brycecherry75/SeriesLoadLimiter/Programmable AC Series Limiter.pdf

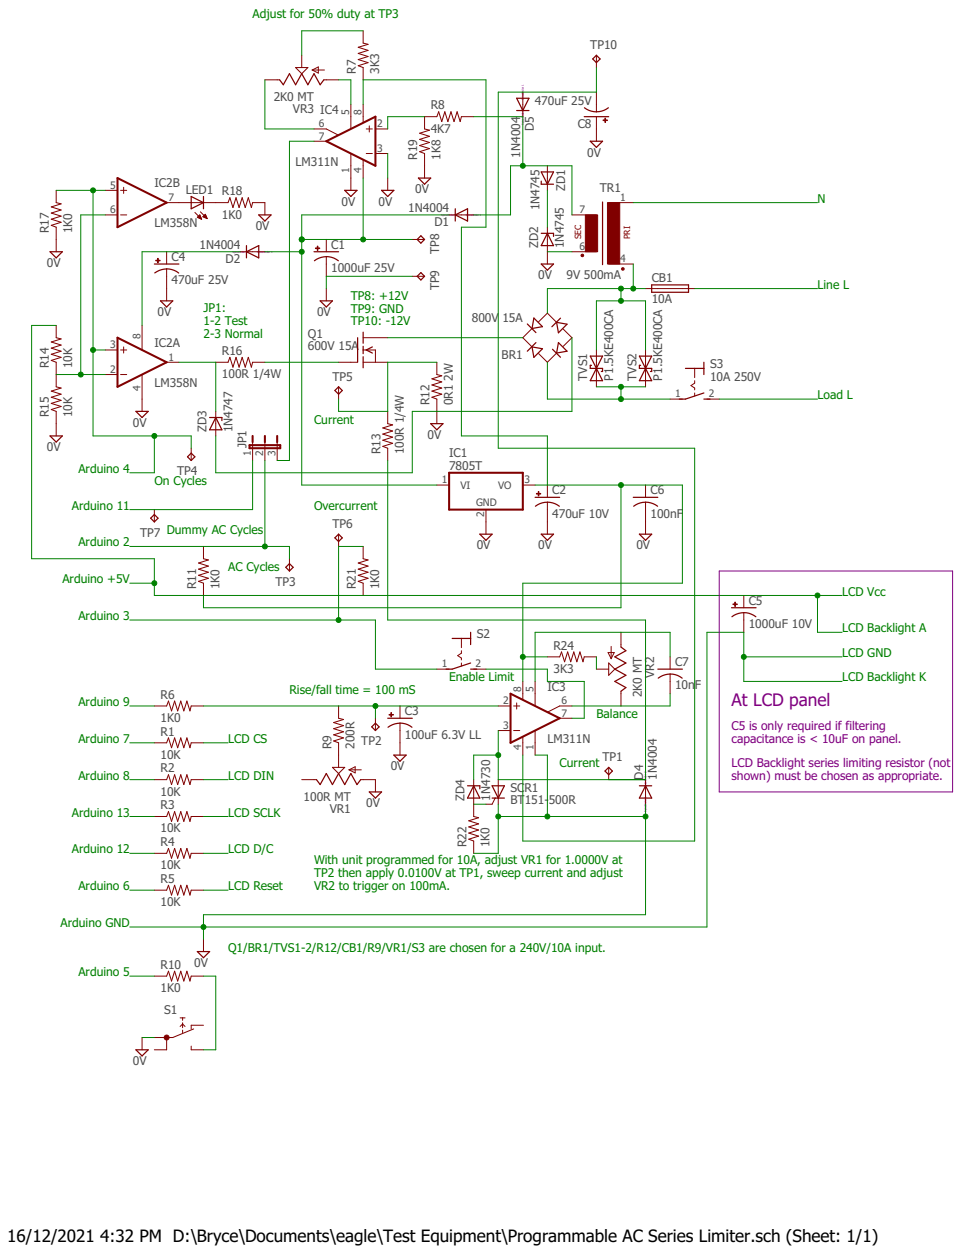
[picture p1: page 1]

Adjust for 50% duty at TP3

LCD Vcc LCD Backlight A

Rise/fall time = 100 mS

LCD Backlight series limiting resistor (not shown) must be chosen as appropriate. At LCD panel

C5 is only required if filtering
capacitance is < 10uF on panel.

With unit programmed for 10A, adjust VR1 for 1.0000V at
TP2 then apply 0.0100V at TP1, sweep current and adjust
VR2 to trigger on 100mA.

Q1/BR1/TVS1-2/R12/CB1/R9/VR1/S3 are chosen for a 240V/10A input. Arduino GND

16/12/2021 4:32 PM D:\Bryce\Documents\eagle\Test Equipment\Programmable AC Series Limiter.sch (Sheet: 1/1)
