brycecherry75/SeriesLoadLimiter/Programmable AC Series Limiter.sch

## EAGLE design Programmable AC Series Limiter.sch (2021-07-10)

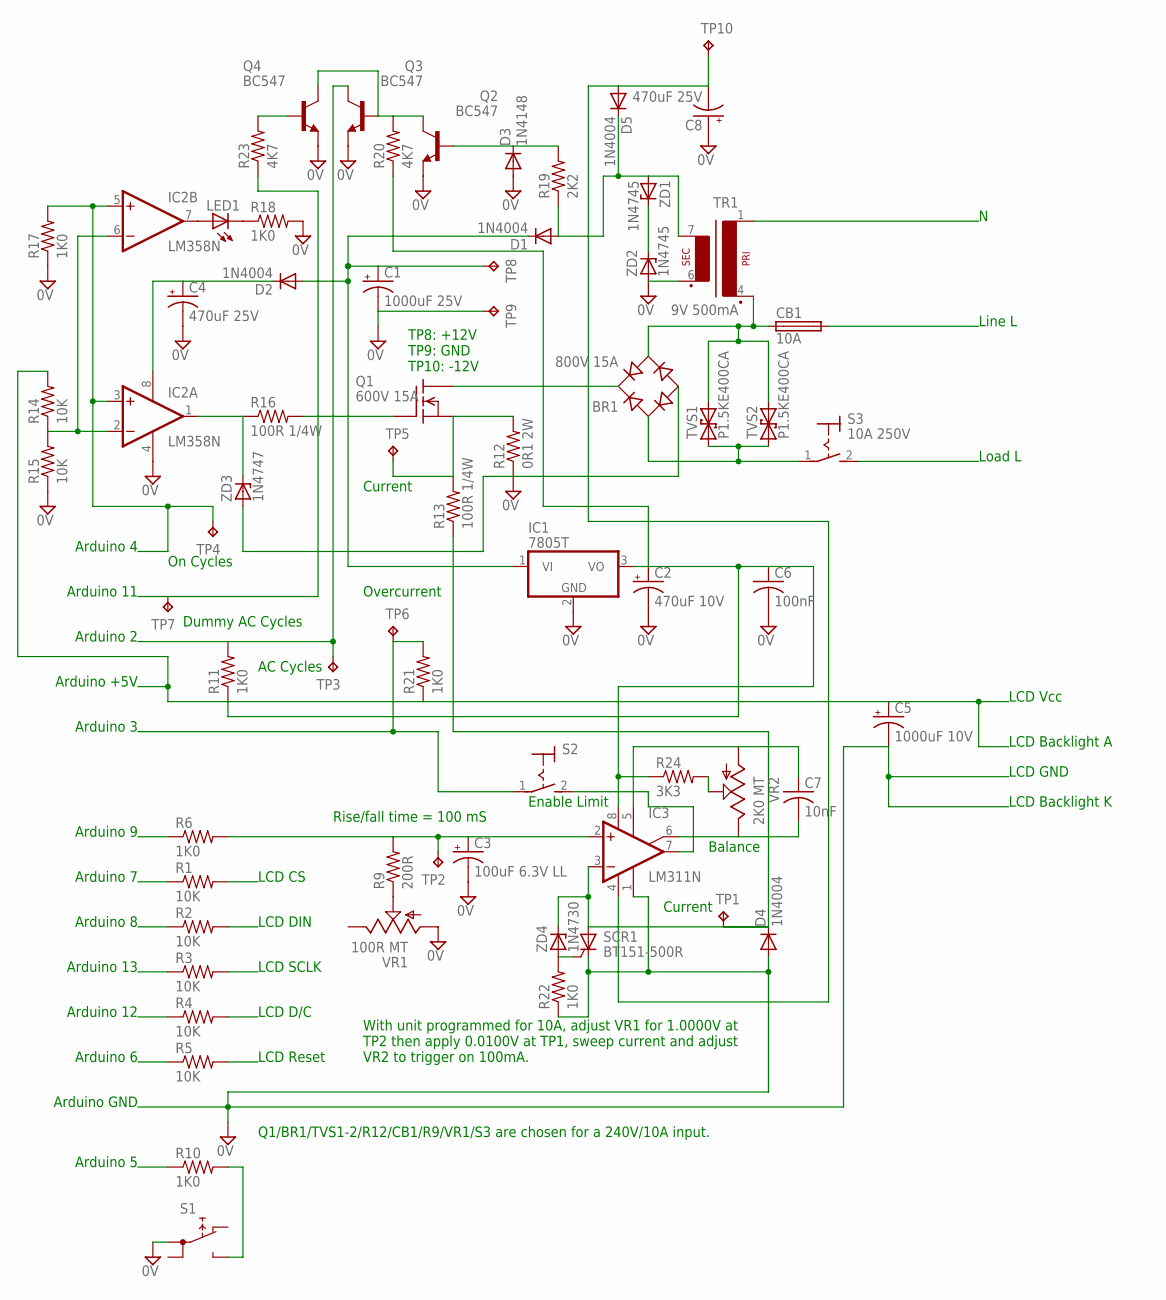
[picture p2: schematic Programmable AC Series Limiter.sch]

Parts:
BR1: 800V 15A; DB
C1: 1000uF 25V; B45181A
C2: 470uF 10V; B45181A
C3: 100uF 6.3V LL; B45181A
C4, C8: 470uF 25V; B45181A
C5: 1000uF 10V; B45181A
C6: 100nF; C025-024X044
C7: 10nF; C025-024X044
CB1: 10A; FUSE_HOLDER_MENTOR-1821
D1, D2, D4, D5: 1N4004; DO41-10
D3: 1N4148; DO35-7
IC1: 7805T; TO220H
IC2: LM358N; DIL08
IC3: LM311N; DIL08
LED1: LED5MM
Q1: 600V 15A; TO220
Q2, Q3, Q4: BC547; TO92
R1, R2, R3, R4, R5, R14, R15: 10K; 0204V
R6, R10, R11, R17, R18, R21, R22: 1K0; 0204V
R9: 200R; 0204V
R12: 0R1 2W; 0204V
R13, R16: 100R 1/4W; 0204V
R19: 2K2; 0204V
R20, R23: 4K7; 0204V
R24: 3K3; 0204V
S1: 5501
S2: MS243
S3: 10A 250V; MS243
SCR1: BT151-500R; TO220CL
TP1, TP2, TP3, TP4, TP5, TP6, TP7, TP8, TP9, TP10: TPB1,27; B1,27
TR1: 9V 500mA; EE20-1
TVS1, TVS2: P1.5KE400CA; CB417-15
VR1: 100R MT; EVUE
VR2: 2K0 MT; EVUE
ZD1, ZD2: 1N4745; C1702-15
ZD3: 1N4747; C1702-15
ZD4: 1N4730; C1702-15

Connections:
GND: BR1.-, C1.-, C2.-, C3.-, C4.-, C5.-, C6.2, C8.+, D3.A, D4.A, IC1.2 (GND), IC2.4 (V-), IC3.1 (GND), Q2.1 (E), Q3.1 (E), Q4.1 (E), R12.1, R15.1, R17.1, R18.2, R22.1, S1.1A, SCR1.C, TP9.TP, TR1.6 (S3), VR1.1 (A), ZD2.A, ZD3.A
unnamed: R22.2, SCR1.G, ZD4.A
unnamed: BR1.+, Q1.2 (D)
unnamed: R10.2, S1.NO
unnamed: C1.+, D1.C, D2.A, IC1.1 (VI), TP8.TP
unnamed: Q1.3 (S), R12.2, R13.2, TP5.TP
unnamed: D3.C, Q2.2 (B), R19.2
unnamed: IC2.1 (OUT), R16.1, ZD3.C
unnamed: Q2.3 (C), Q3.2 (B), Q4.3 (C), R20.2
unnamed: Q1.1 (G), R16.2
unnamed: IC2.7 (OUT), LED1.A
unnamed: R9.1, VR1.2 (S)
unnamed: IC2.2 (-IN), IC2.6 (-IN), R14.1, R15.2
unnamed: ZD1.C, ZD2.C
unnamed: BR1.AC2, CB1.A (1), TR1.4 (P2), TVS1.C (2), TVS2.C (2)
unnamed: D4.C, IC3.3 (-IN), R13.1, SCR1.A, TP1.TP, ZD4.C
unnamed: D1.A, D5.C, R19.1, TR1.7 (S4), ZD1.A
unnamed: R21.2, S2.1, TP6.TP
unnamed: IC2.3 (+IN), IC2.5 (+IN), R17.2, TP4.TP
unnamed: Q3.3 (C), R11.2, TP3.TP
unnamed: LED1.K (C), R18.1
unnamed: C4.+, D2.C, IC2.8 (V+)
unnamed: C3.+, IC3.2 (+IN), R6.2, R9.2, TP2.TP
unnamed: R24.2, VR2.2 (S)
unnamed: BR1.AC1, S3.1, TVS1.A (1), TVS2.A (1)
unnamed: C8.-, D5.A, IC3.4 (V-), TP10.TP
unnamed: C7.1, IC3.5 (ON), VR2.1 (A)
unnamed: C7.2, IC3.6 (ON/STR), VR2.3 (E)
unnamed: C2.+, C5.+, C6.1, IC1.3 (VO), IC3.8 (V+), R11.1, R14.2, R20.1, R21.1, R24.1
unnamed: R23.1, TP7.TP
unnamed: IC3.7 (OUT), S2.2 (S)
unnamed: Q4.2 (B), R23.2

Notes on the sheet:
LCD CS
LCD DIN
LCD SCLK
LCD D/C
LCD Reset
LCD Backlight K
Arduino 7
Arduino 8
Arduino 13
Arduino 12
Arduino 6
Arduino 5
Arduino 9
Arduino 3
Arduino +5V
Arduino 2
Arduino 4
Line L
Load L
Enable Limit
Rise/fall time = 100 mS
Q1/BR1/TVS1-2/R12/CB1/R9/VR1/S3 are chosen for a 240V/10A input.
Arduino GND
LCD Vcc
LCD Backlight A
LCD GND
Current
AC Cycles
On Cycles
Overcurrent
Arduino 11
Dummy AC Cycles
Balance
TP8: +12V TP9: GND TP10: -12V
With unit programmed for 10A, adjust VR1 for 1.0000V at TP2 then apply 0.0100V at TP1, sweep current and adjust VR2 to trigger on 100mA.
